cyril-L/arduino_api_lanveur/arduino/lanveur_schematics/lanveur_schematics.pdf

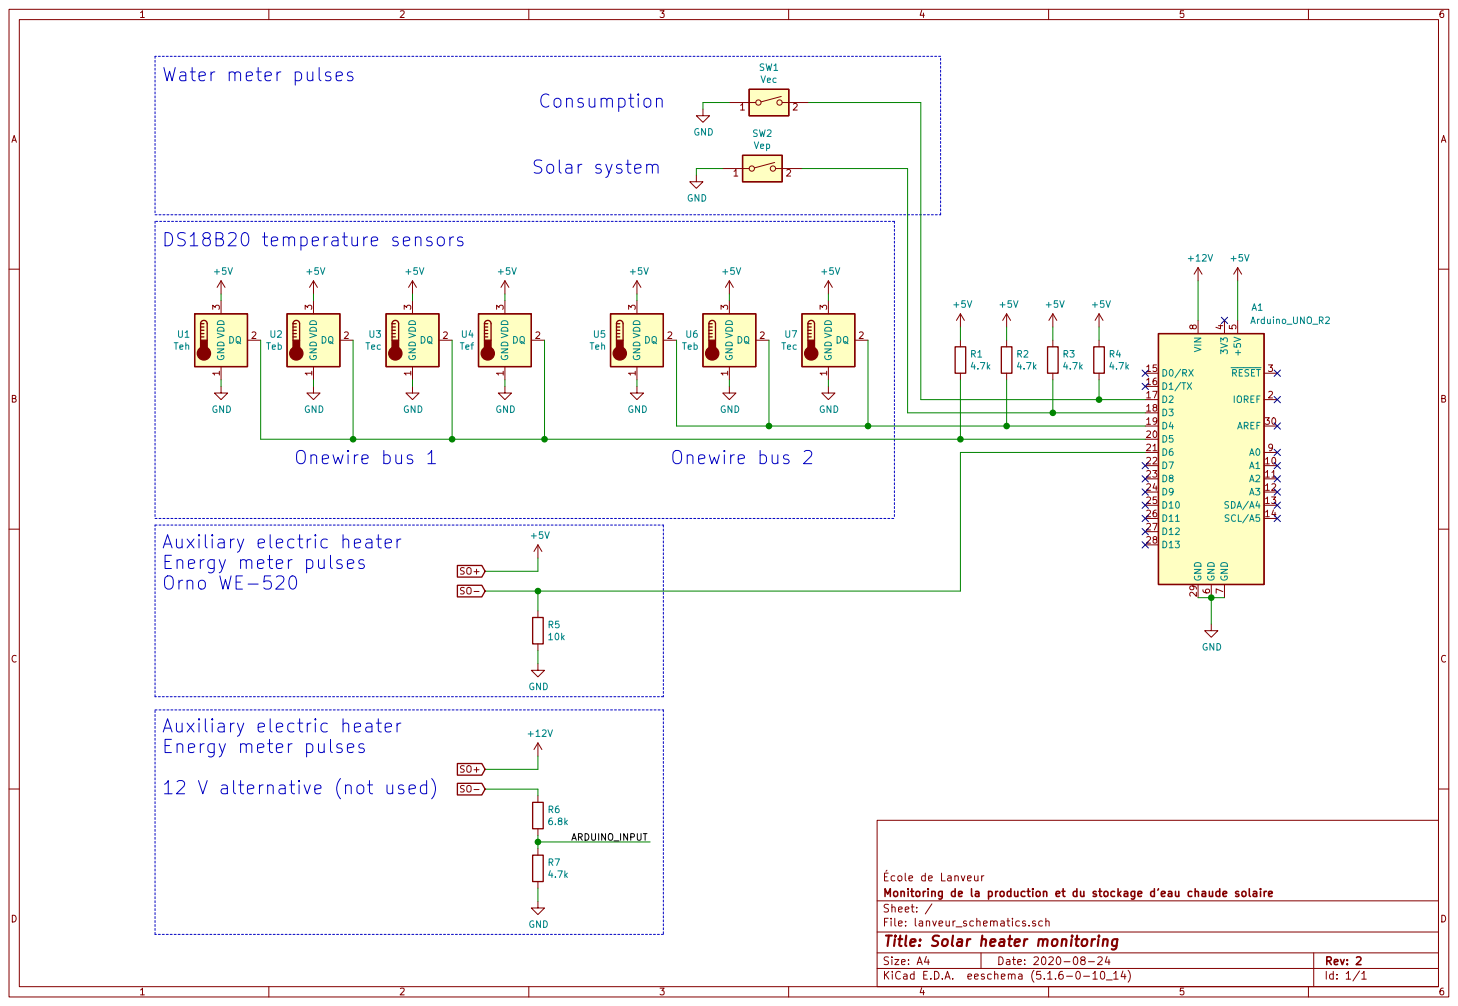
[picture p2: page 1]

École de Lanveur GND

File: lanveur_schematics.sch Sheet: / Monitoring de la production et du stockage deau chaude solaire

Id: 1/1 Title: Solar heater monitoring
