cyril-L/arduino_api_lanveur/arduino/lanveur_schematics/lanveur_schematics.sch

## KiCad design arduino/lanveur_schematics/lanveur_schematics.sch (2020-08-24)

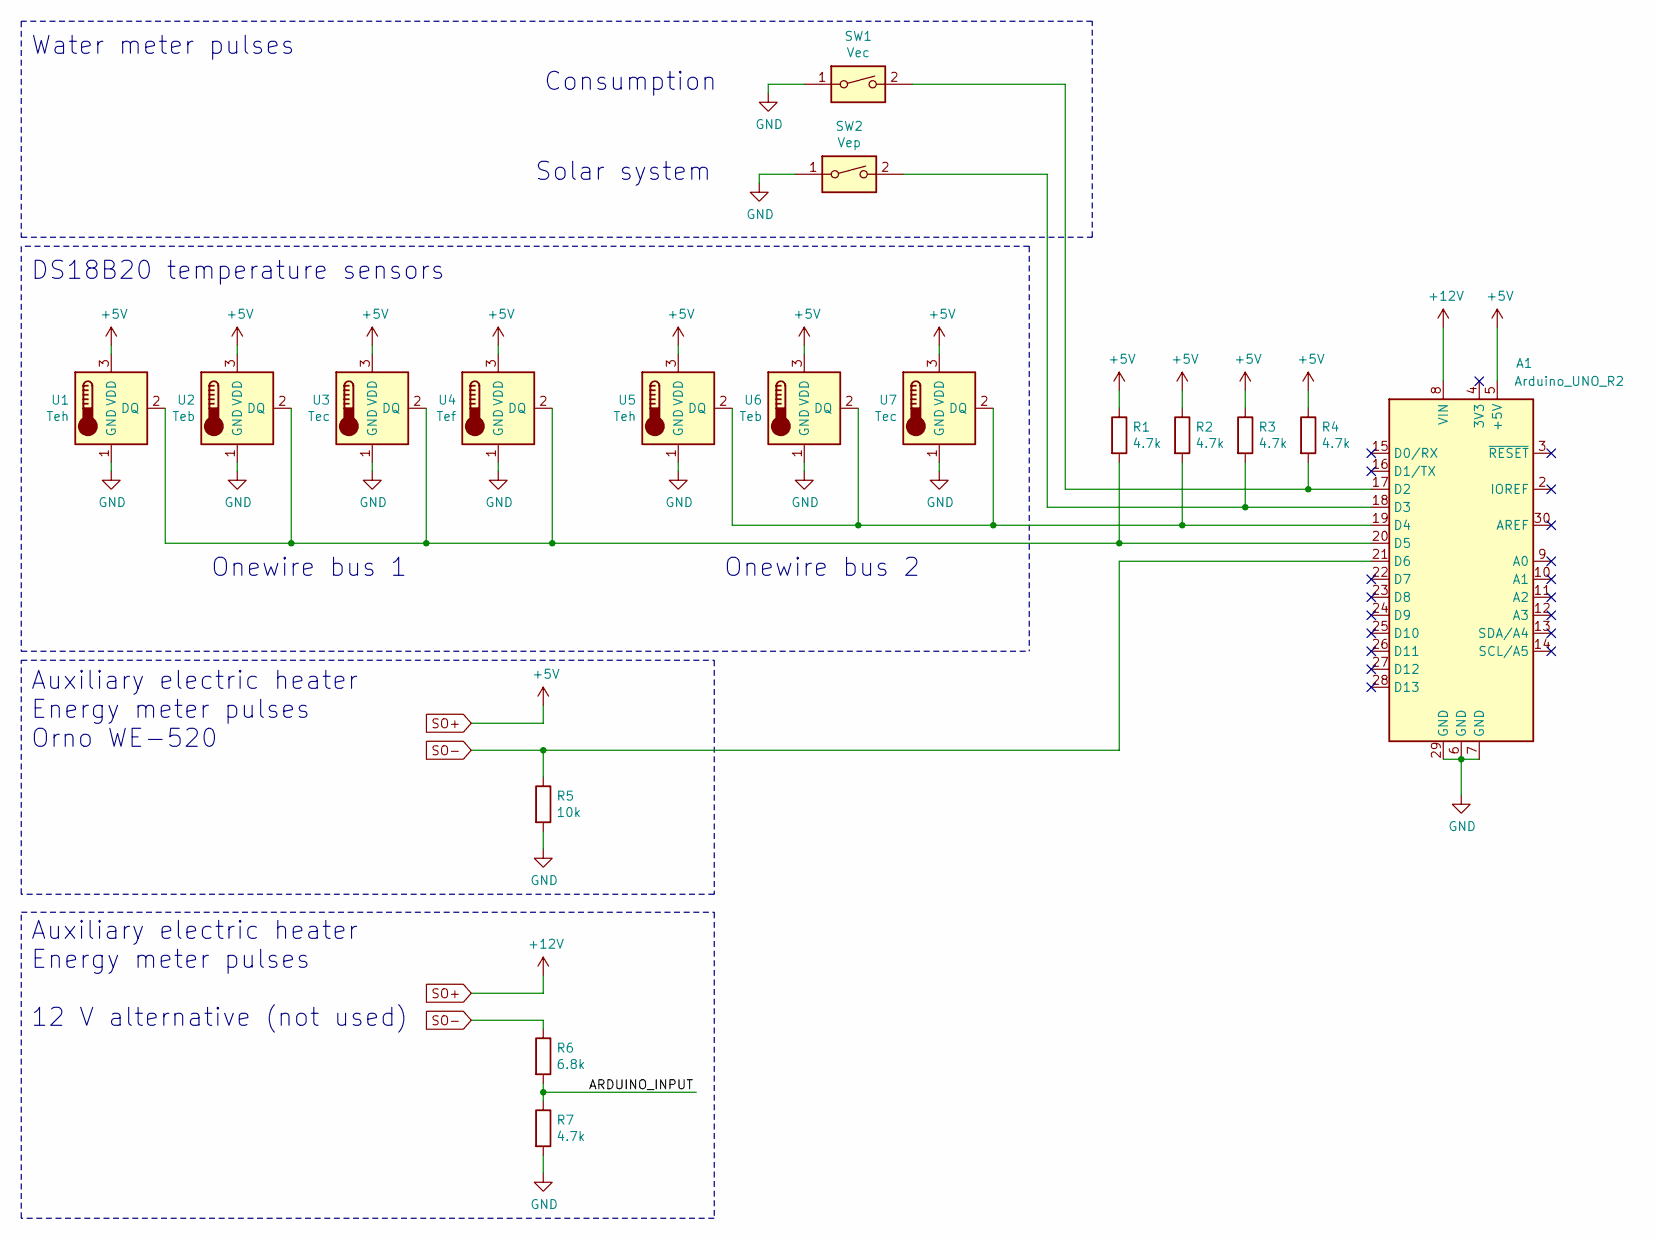
[picture p3: schematic lanveur_schematics.sch]

Parts:
A1: Arduino_UNO_R2
R1, R2, R3, R4, R7: 4.7k
R5: 10k
R6: 6.8k
SW1: Vec
SW2: Vep
U1, U5: Teh; TO-92_Inline
U2, U6: Teb; TO-92_Inline
U3, U7: Tec; TO-92_Inline
U4: Tef; TO-92_Inline

Connections:
+12V: A1.5 (+5V), A1.8 (VIN), R1.1, R2.1, R3.1, R4.1, U1.3 (VDD), U2.3 (VDD), U3.3 (VDD), U4.3 (VDD), U5.3 (VDD), U6.3 (VDD), U7.3 (VDD)
ARDUINO_INPUT: R6.2, R7.1
GND: A1.6 (GND), A1.7 (GND), A1.29 (GND), R5.2, R7.2, SW1.1, SW2.1, U1.1 (GND), U2.1 (GND), U3.1 (GND), U4.1 (GND), U5.1 (GND), U6.1 (GND), U7.1 (GND)
unnamed: A1.17 (D2), R4.2, SW1.2
unnamed: A1.18 (D3), R3.2, SW2.2
unnamed: A1.19 (D4), R2.2, U5.2 (DQ), U6.2 (DQ), U7.2 (DQ)
unnamed: A1.20 (D5), R1.2, U1.2 (DQ), U2.2 (DQ), U3.2 (DQ), U4.2 (DQ)
SO-: A1.21 (D6), R5.1, R6.1

Notes on the sheet:
Water meter pulses
DS18B20 temperature sensors
Onewire bus 1
Onewire bus 2
Consumption
Solar system
Auxiliary electric heater Energy meter pulses 12 V alternative (not used)
Auxiliary electric heater Energy meter pulses Orno WE-520
