cyril-L/arduino_api_lanveur/config.py

import os

ROOT_DIR = os.path.dirname(os.path.realpath(__file__))

SOLAR_PANNEL_AREA = 6 # m²

STORED_WATER_VOLUME = 0.3 # m³

AUX_ENERGY_METER_TICKS_PER_KWH = 800
SOLAR_WATER_METER_TICKS_PER_L = 1
USED_WATER_METER_TICKS_PER_L = 1

SERIAL_DEVICE = "/dev/ttyACM0"
SERIAL_BAUDRATE = 9600

# Time to atempt a new connection when the previous failed
SERIAL_RECONNECT_TIMEOUT_S = 15

# The Arduino will be reset when no valid data have been received during this duration
FRESH_DATA_TIMEOUT_S = 10

# Where / how often save persistent counters
COUNTERS_FILE_PATH = os.path.join(ROOT_DIR, "counters.json")
COUNTERS_FILE_SAVE_PERIOD_MIN = 10
