cyril-L/arduino_api_lanveur/(commit log)

2020-04-17 Continuously read data from Arduino
2020-04-17 Guessing the current values order
2020-04-19 Trying to understand temperature sensor locations
2020-04-20 Do not reset fresh data timeout on invalid data
    [config.py, serial_reader.py]
2020-05-04 Using one wire library from pjrc
    https://github.com/PaulStoffregen/OneWire
2020-05-04 Reproduced legacy Arduino code behaviour
2020-07-08 Read auxiliary power
    - Implemented a generic arduino edge input
    - Refactored serial format (still readable ascii)
    - Changed higher level to take those changes into account
2020-07-09 Counting aux kWh, fixed water meter
    [data_processing.py]
2020-08-21 Testing SVG schematics
2020-08-24 Added schematic
    [lanveur_schematics.sch]
2020-08-24 Scan one wire bus on serial input
